arthurbumblebee/Autonomous-Ice-cream-truck/IMG_1965.JPG

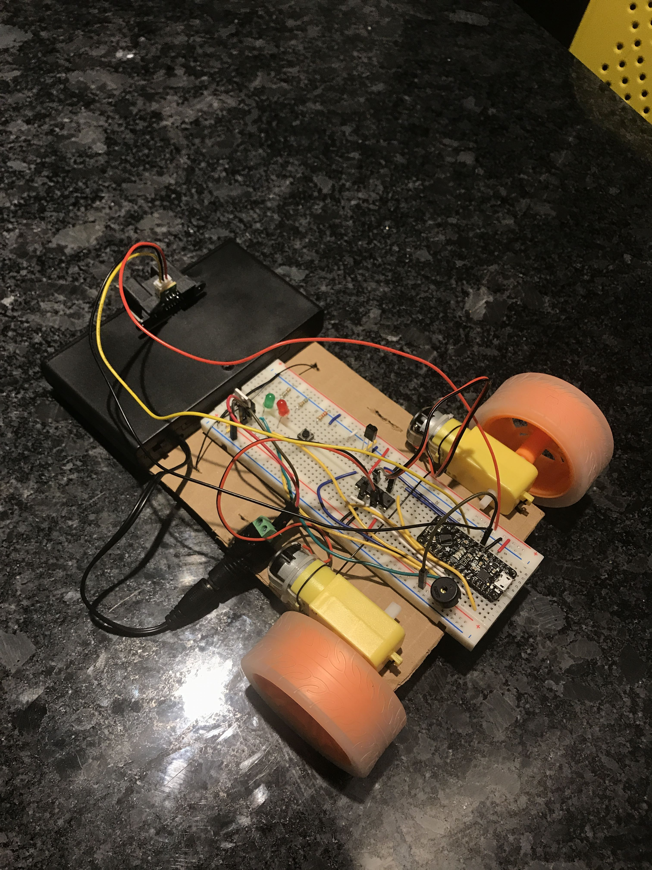
IMG_1965.JPG
